harikrishnanm5/Flight-Data-Logger-PCB/BOM.csv

Designators | Qty | Value | Footprint | MPN | Placement_Side | Description
H1, H2, H3, H4 | 4 | M3_GND | MountingHole_3.2mm_M3_Pad_TopBottom | M3_HOLE | F | M3 Drone Stack Hole NW; M3 Drone Stack Hole NE; M3 Drone Stack Hole SW ...
U2 | 1 | ESP32-WROOM-32 | ESP32-WROOM-32 | ESP32-WROOM-32E-N4 | F | Wi-Fi/BLE Telemetry Module
U1 | 1 | STM32F446RET6 | LQFP-64_10x10mm_P0.5mm | STM32F446RET6 | F | ARM Cortex-M4F MCU 180MHz 512KB
U3 | 1 | MPU-6050 | InvenSense_QFN-24_4x4mm_P0.5mm | MPU-6050 | F | 6-Axis IMU (I2C 0x68, AD0=GND)
U4 | 1 | BMP280 | Bosch_LGA-8_2x2.5mm_P0.65mm_ClockwisePinNumbering | BMP280 | F | Barometric Pressure Sensor (I2C 0x76)
J3 | 1 | MicroSD_SPI | microSD_HC_Hirose_DM3D-SF | DM3D-SF | F | MicroSD Card Push-Pull Socket (SPI)
C_SC1 | 1 | 1.0F_5.5V | DX_5R5VxxxxU_D11.5mm_P5.00mm | DX-5R5V105U | F | 5.5V 1.0F Backup Supercapacitor
J1 | 1 | JST_PH_BATT | JST_PH_B2B-PH-K_1x02_P2.00mm_Vertical | B2B-PH-K-S | F | 3.7V Li-ion Input JST-PH 2-Pin
J2 | 1 | SWD_5P | PinHeader_1x05_P2.54mm_Vertical | HDR-1x5-2.54 | F | SWD Debug (3V3, SWCLK, GND, SWDIO, NRST)
J4 | 1 | ESP_UART_6P | PinHeader_1x06_P1.27mm_Vertical | HDR-1x6-1.27 | F | ESP32 UART/Flash 6-Pin Header
SW1 | 1 | RESET | SW_SPST_CK_KXT3 | KXT311LHS | F | MCU Reset Tactile Switch
D1 | 1 | BEACON_LED_HI | LED_PLCC_2835 | SM2835-RED-HI | F | High-Intensity Optical Emergency Beacon LED
D2 | 1 | STAT_GREEN | LED_0603_1608Metric | LTST-C190KGKT | F | Status / Logger Activity LED (PC5)
D3 | 1 | PWR_BLUE | LED_0603_1608Metric | LTST-C190TBKT | F | 3.3V Power Indicator LED
Y1 | 1 | 8MHz | Crystal_SMD_3225-4Pin_3.2x2.5mm | ABM8-8.000MHZ-B2-T | F | 8 MHz HSE Crystal
Y2 | 1 | 32.768kHz | Crystal_SMD_3215-2Pin_3.2x1.5mm | ABS07-32.768KHZ-T | F | 32.768 kHz LSE RTC Crystal
C3, C4 | 2 | 18pF | C_0603_1608Metric | CC0603JRNPO9BN180 | F | HSE Load Cap 1; HSE Load Cap 2
C5, C6 | 2 | 12pF | C_0603_1608Metric | CC0603JRNPO9BN120 | F | LSE Load Cap 1; LSE Load Cap 2
R5, R6, R7, R8, R9, R10, R20, R11, R23, R25, R26, R36, R12, R13, R14, R15 | 16 | 10k | R_0603_1608Metric | RC0603FR-0710KL | B/F | SD_CS Pull-up; SPI1_MISO Pull-up; SPI1_MOSI Pull-up ...
C21, C27 | 2 | 10uF | C_0805_2012Metric | CL21A106KAYNNNE | B/F | SD VDD Bulk Cap; Buck Input Decoupling Cap
C22, C17, C19, C20, C31, C32, C1, C14, C8, C9, C10, C11, C2, C15, C16, C24, C25 | 17 | 100nF | C_0603_1608Metric | CC0603KRX7R7BB104 | B/F | SD VDD Decoupling Cap; MPU-6050 REGOUT Cap; BMP280 VDD Decoupling ...
Q4 | 1 | 2N7002 | SOT-23 | 2N7002LT1G | F | Beacon N-MOSFET Driver
R18 | 1 | 22R | R_0805_2012Metric | ERJ-6GEYJ220V | F | Beacon LED Current Limit
R19, R16, R17 | 3 | 100R | R_0603_1608Metric | RC0603FR-07100RL | B/F | Beacon Gate Series R; USART1 TX -> ESP RXD0 Series; ESP TXD0 -> USART1 RX Series
R21, R22 | 2 | 1k | R_0603_1608Metric | RC0603FR-071KL | F | Status LED Resistor; Power LED Resistor
R3, R4 | 2 | 4.7k | R_0603_1608Metric | RC0603FR-074K7L | F | I2C1 SCL Pull-up; I2C1 SDA Pull-up
C18 | 1 | 2.2nF | C_0603_1608Metric | CC0603KRX7R9BB222 | F | MPU-6050 CPOUT Charge Pump Cap
U5 | 1 | CY15B102QN-50SXIT | SOIC-8_3.9x4.9mm_P1.27mm | CY15B102QN-50SXIT | B | 2 Mbit SPI FRAM Non-Volatile Memory
Q1, Q2, Q3 | 3 | AO3401A | SOT-23 | AO3401A | B | Reverse-Polarity P-MOSFET; Primary Battery Ideal Diode P-MOSFET; Supercap Backup Ideal Diode P-MOSFET
C26, C13 | 2 | 1uF | C_0603_1608Metric | CL10A105KB8NNNC | B | Fast-Trip Input Cap; VDDA Bulk Cap
U7, U8 | 2 | LTC4412ES6 | TSOT-23-6 | LTC4412ES6#TRPBF | B | Primary Battery PowerPath Ideal Diode Ctrl; Supercap Backup Ideal Diode OR-ing Ctrl
U11 | 1 | AP22814AW5 | SOT-23-5 | AP22814AW5-7 | B | Slew-Limited Supercap Charge Switch
R24 | 1 | 15R | R_0805_2012Metric | ERJ-6GEYJ150V | B | Supercap Charge Current Limit (~200mA)
D4 | 1 | B5819W | D_SOD-123 | B5819W-7-F | B | Supercap Blocking Schottky Diode
U6 | 1 | TPS62822DLC | Texas_VSON-HR-8_1.5x2mm_P0.5mm | TPS62822DLCR | B | 3.3V 2A Synchronous Buck Regulator
L1 | 1 | 1.0uH_3.5A | L_Wuerth_MAPI-3015 | 74438334010 | B | 1.0uH Shielded Buck Power Inductor
C28, C29, C23 | 3 | 22uF | C_0805_2012Metric | CL21A226MAYNNNE | B | Buck Output Bulk Cap 1; Buck Output Bulk Cap 2; ESP32 VDD Bulk Cap
R27 | 1 | 45.3k_1% | R_0603_1608Metric | RC0603FR-0745K3L | B | Buck FB Top (3.318V)
R28, R31, R32, R34 | 4 | 10.0k_1% | R_0603_1608Metric | RC0603FR-0710KL | B | Buck FB Bottom; PFD Ref Divider Top (1.250V); PFD Ref Divider Bottom ...
C30 | 1 | 22pF | C_0603_1608Metric | CC0603JRNPO9BN220 | B | Buck FB Feedforward Cap
R29 | 1 | 100k | R_0603_1608Metric | RC0603FR-07100KL | B | Buck PG Pull-up
U9 | 1 | TLV7031DBV | SOT-23-5 | TLV7031DBVR | B | PFD Comparator (3.00V Trip -> PB1 EXTI1)
U10 | 1 | LM4040DBZ-2.5 | SOT-23 | LM4040AIM3-2.5 | B | 2.500V Precision Shunt Reference
R30 | 1 | 1.5k | R_0603_1608Metric | RC0603FR-071K5L | B | LM4040 Bias Resistor
R33 | 1 | 14.0k_1% | R_0603_1608Metric | RC0603FR-0714KL | B | PFD Sense Divider Top (3.00V)
R35 | 1 | 470k | R_0603_1608Metric | RC0603FR-07470KL | B | PFD Positive Hysteresis (~53mV)
R1 | 1 | 10k_0.1% | R_0603_1608Metric | ERA-3AEB103V | B | ADC1 Divider Top (0.1%)
R2 | 1 | 2k_0.1% | R_0603_1608Metric | ERA-3AEB202V | B | ADC1 Divider Bottom (0.1%)
FB1 | 1 | 600R@100MHz | L_0603_1608Metric | BLM18AG601SN1D | B | VDDA Analog Filter Bead
C7 | 1 | 2.2uF | C_0603_1608Metric | CL10A225KQ8NNNC | B | STM32 VCAP_1 Core Cap
C12 | 1 | 4.7uF | C_0603_1608Metric | CL10A475KQ8NNNC | B | MCU VDD Bulk Cap
