harikrishnanm5/Flight-Data-Logger-PCB/layers/FlightDataLogger-B_Cu.pdf

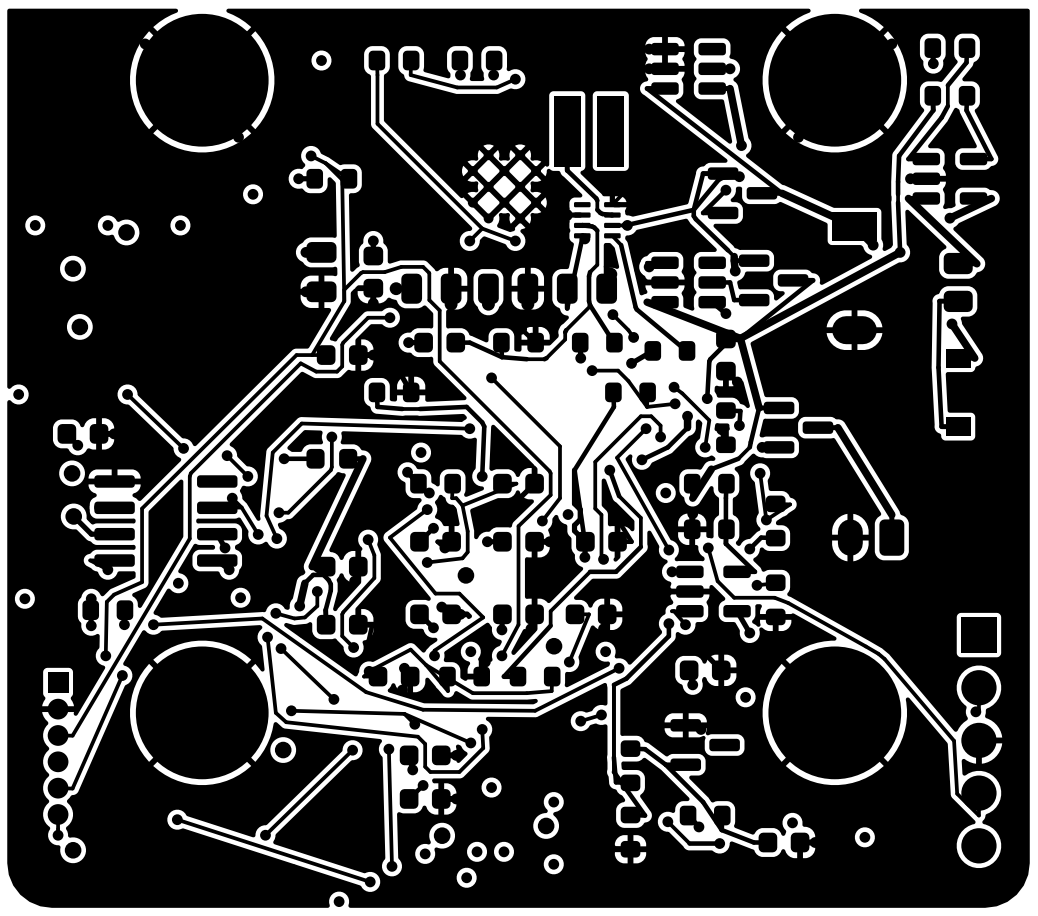
[picture p1: page 1]
