harikrishnanm5/Flight-Data-Logger-PCB/layers/FlightDataLogger-Edge_Cuts.pdf

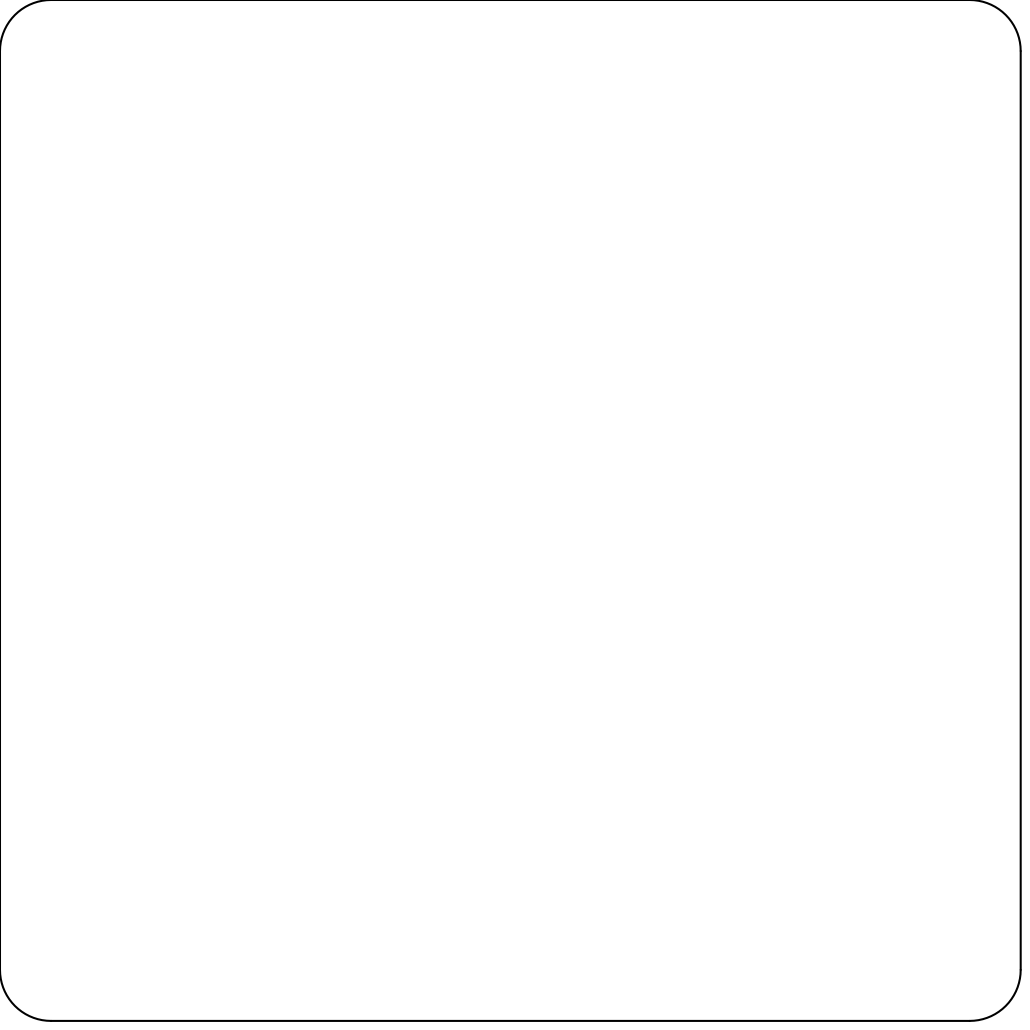
[picture p2: page 1]
