harikrishnanm5/Flight-Data-Logger-PCB/layers/FlightDataLogger-F_Cu.pdf

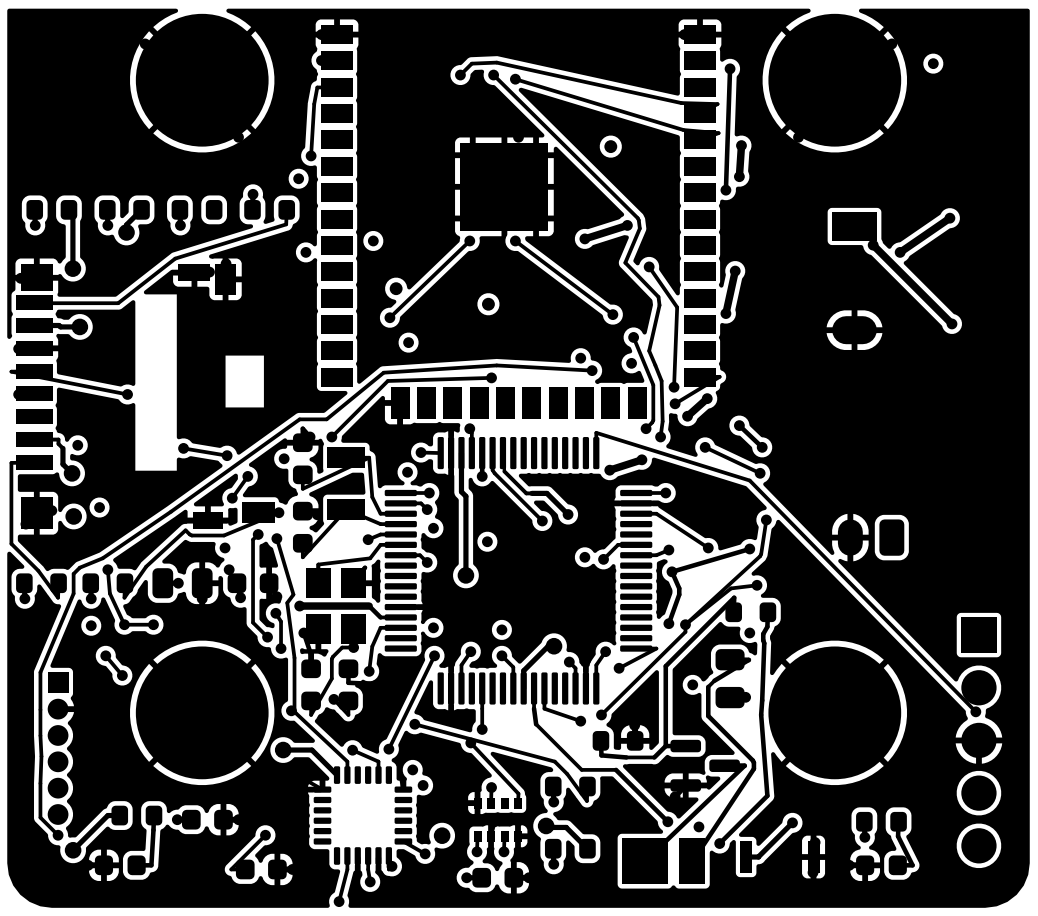
[picture p3: page 1]
