harikrishnanm5/Flight-Data-Logger-PCB/layers/FlightDataLogger-In1_Cu.pdf

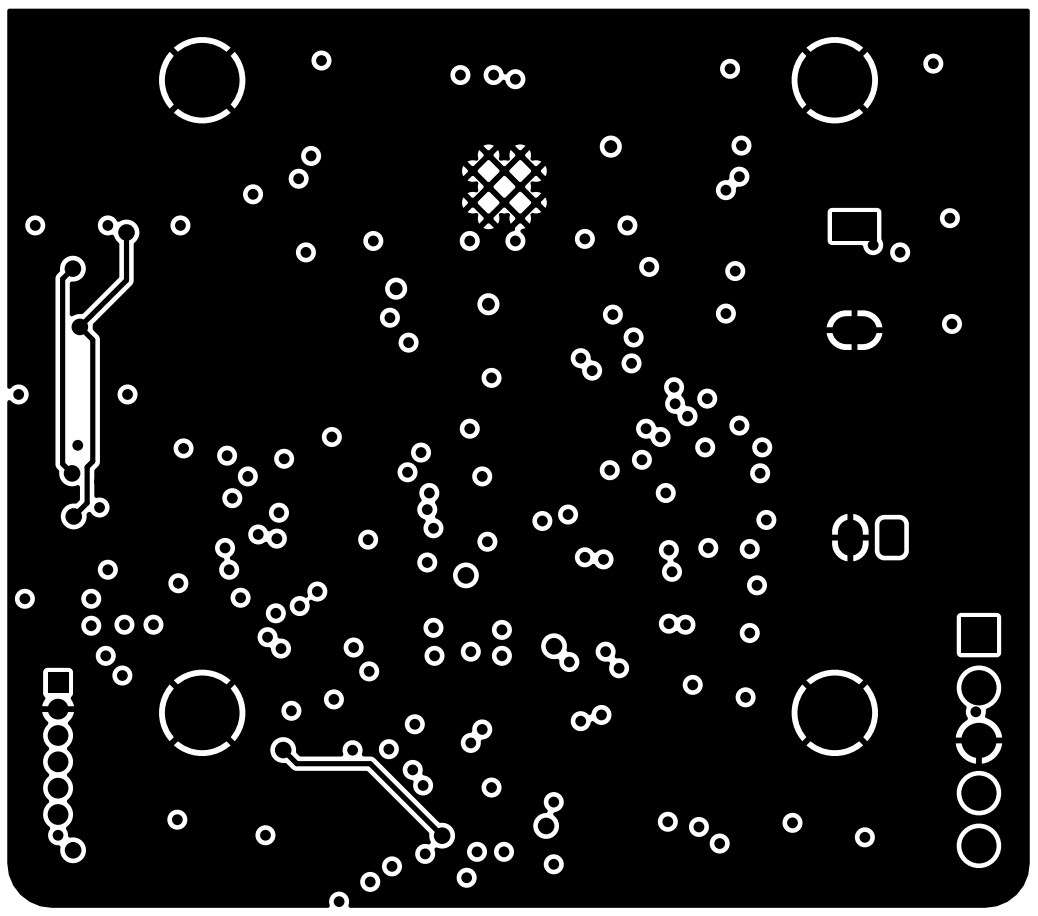
[picture p4: page 1]
