harikrishnanm5/Flight-Data-Logger-PCB/layers/FlightDataLogger-In2_Cu.pdf

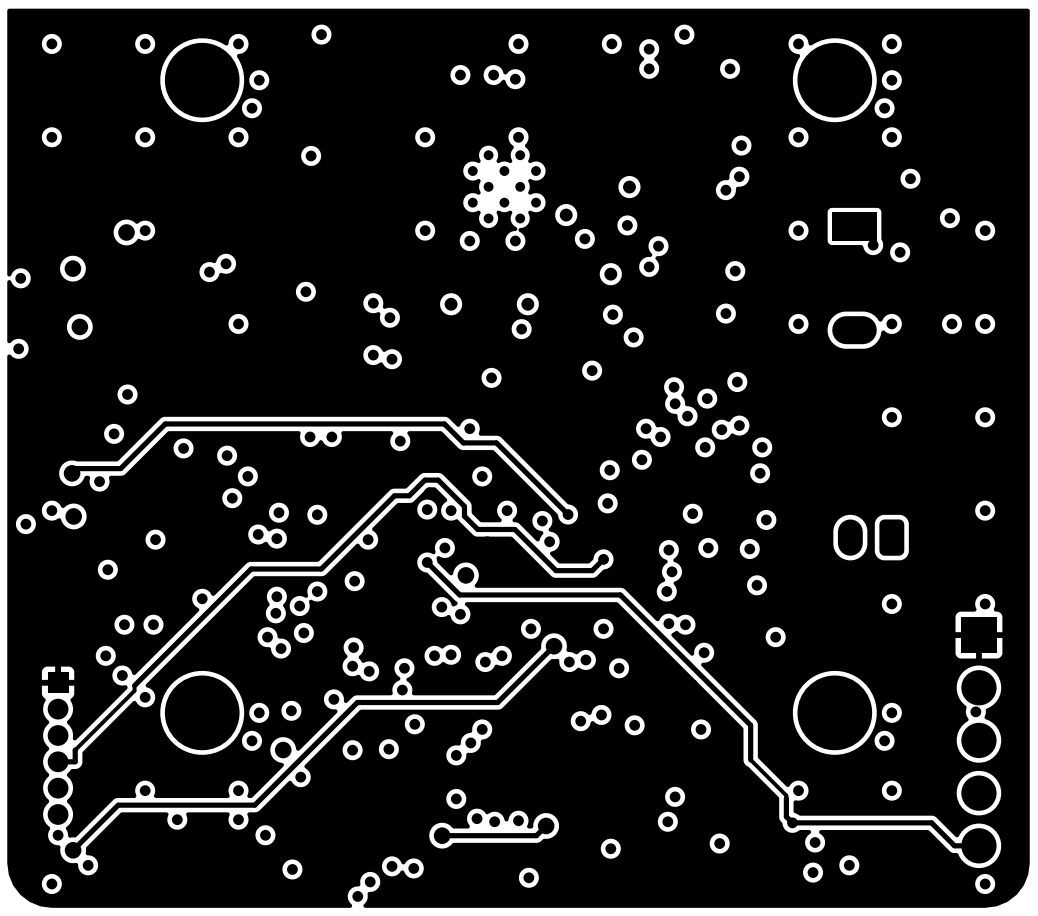
[picture p5: page 1]
