harikrishnanm5/Flight-Data-Logger-PCB/FlightDataLogger.kicad_pcb

## KiCad design FlightDataLogger.kicad_pcb (2026-11-12)

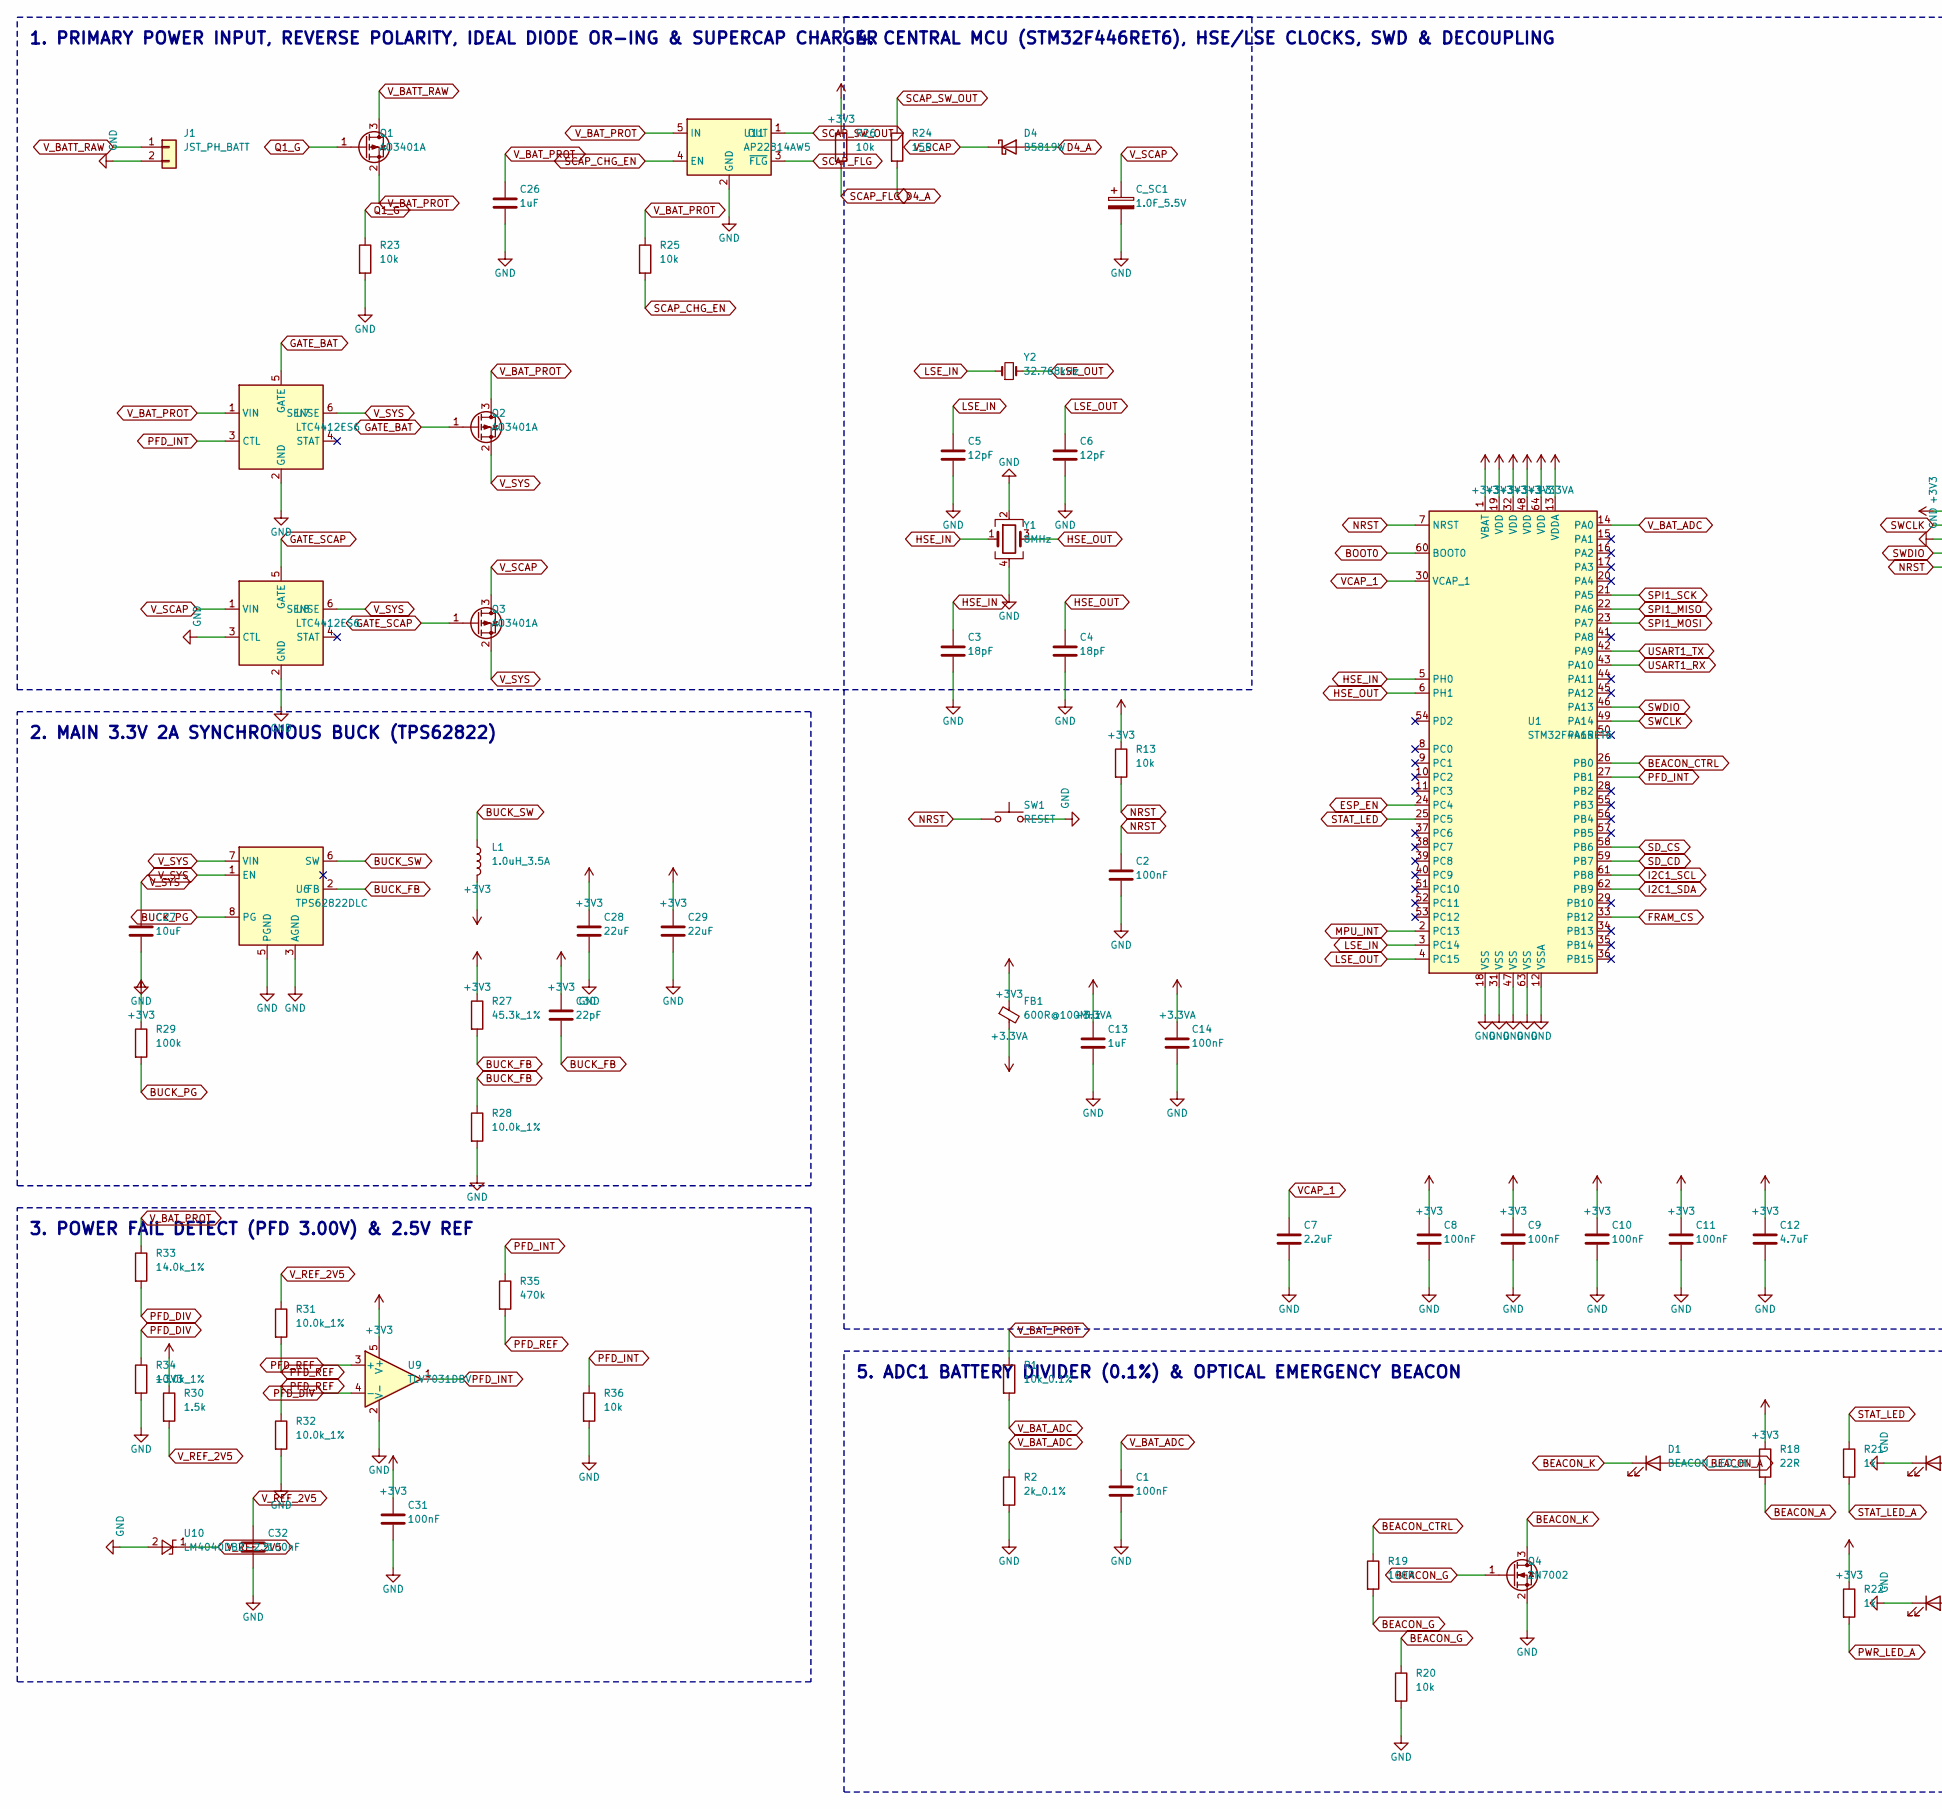
[picture p6: schematic FlightDataLogger.kicad_sch, Crash-Safe UAV Flight Data Logger (STM32F446RE + ESP32 + FR…, part in row 1, column 1]

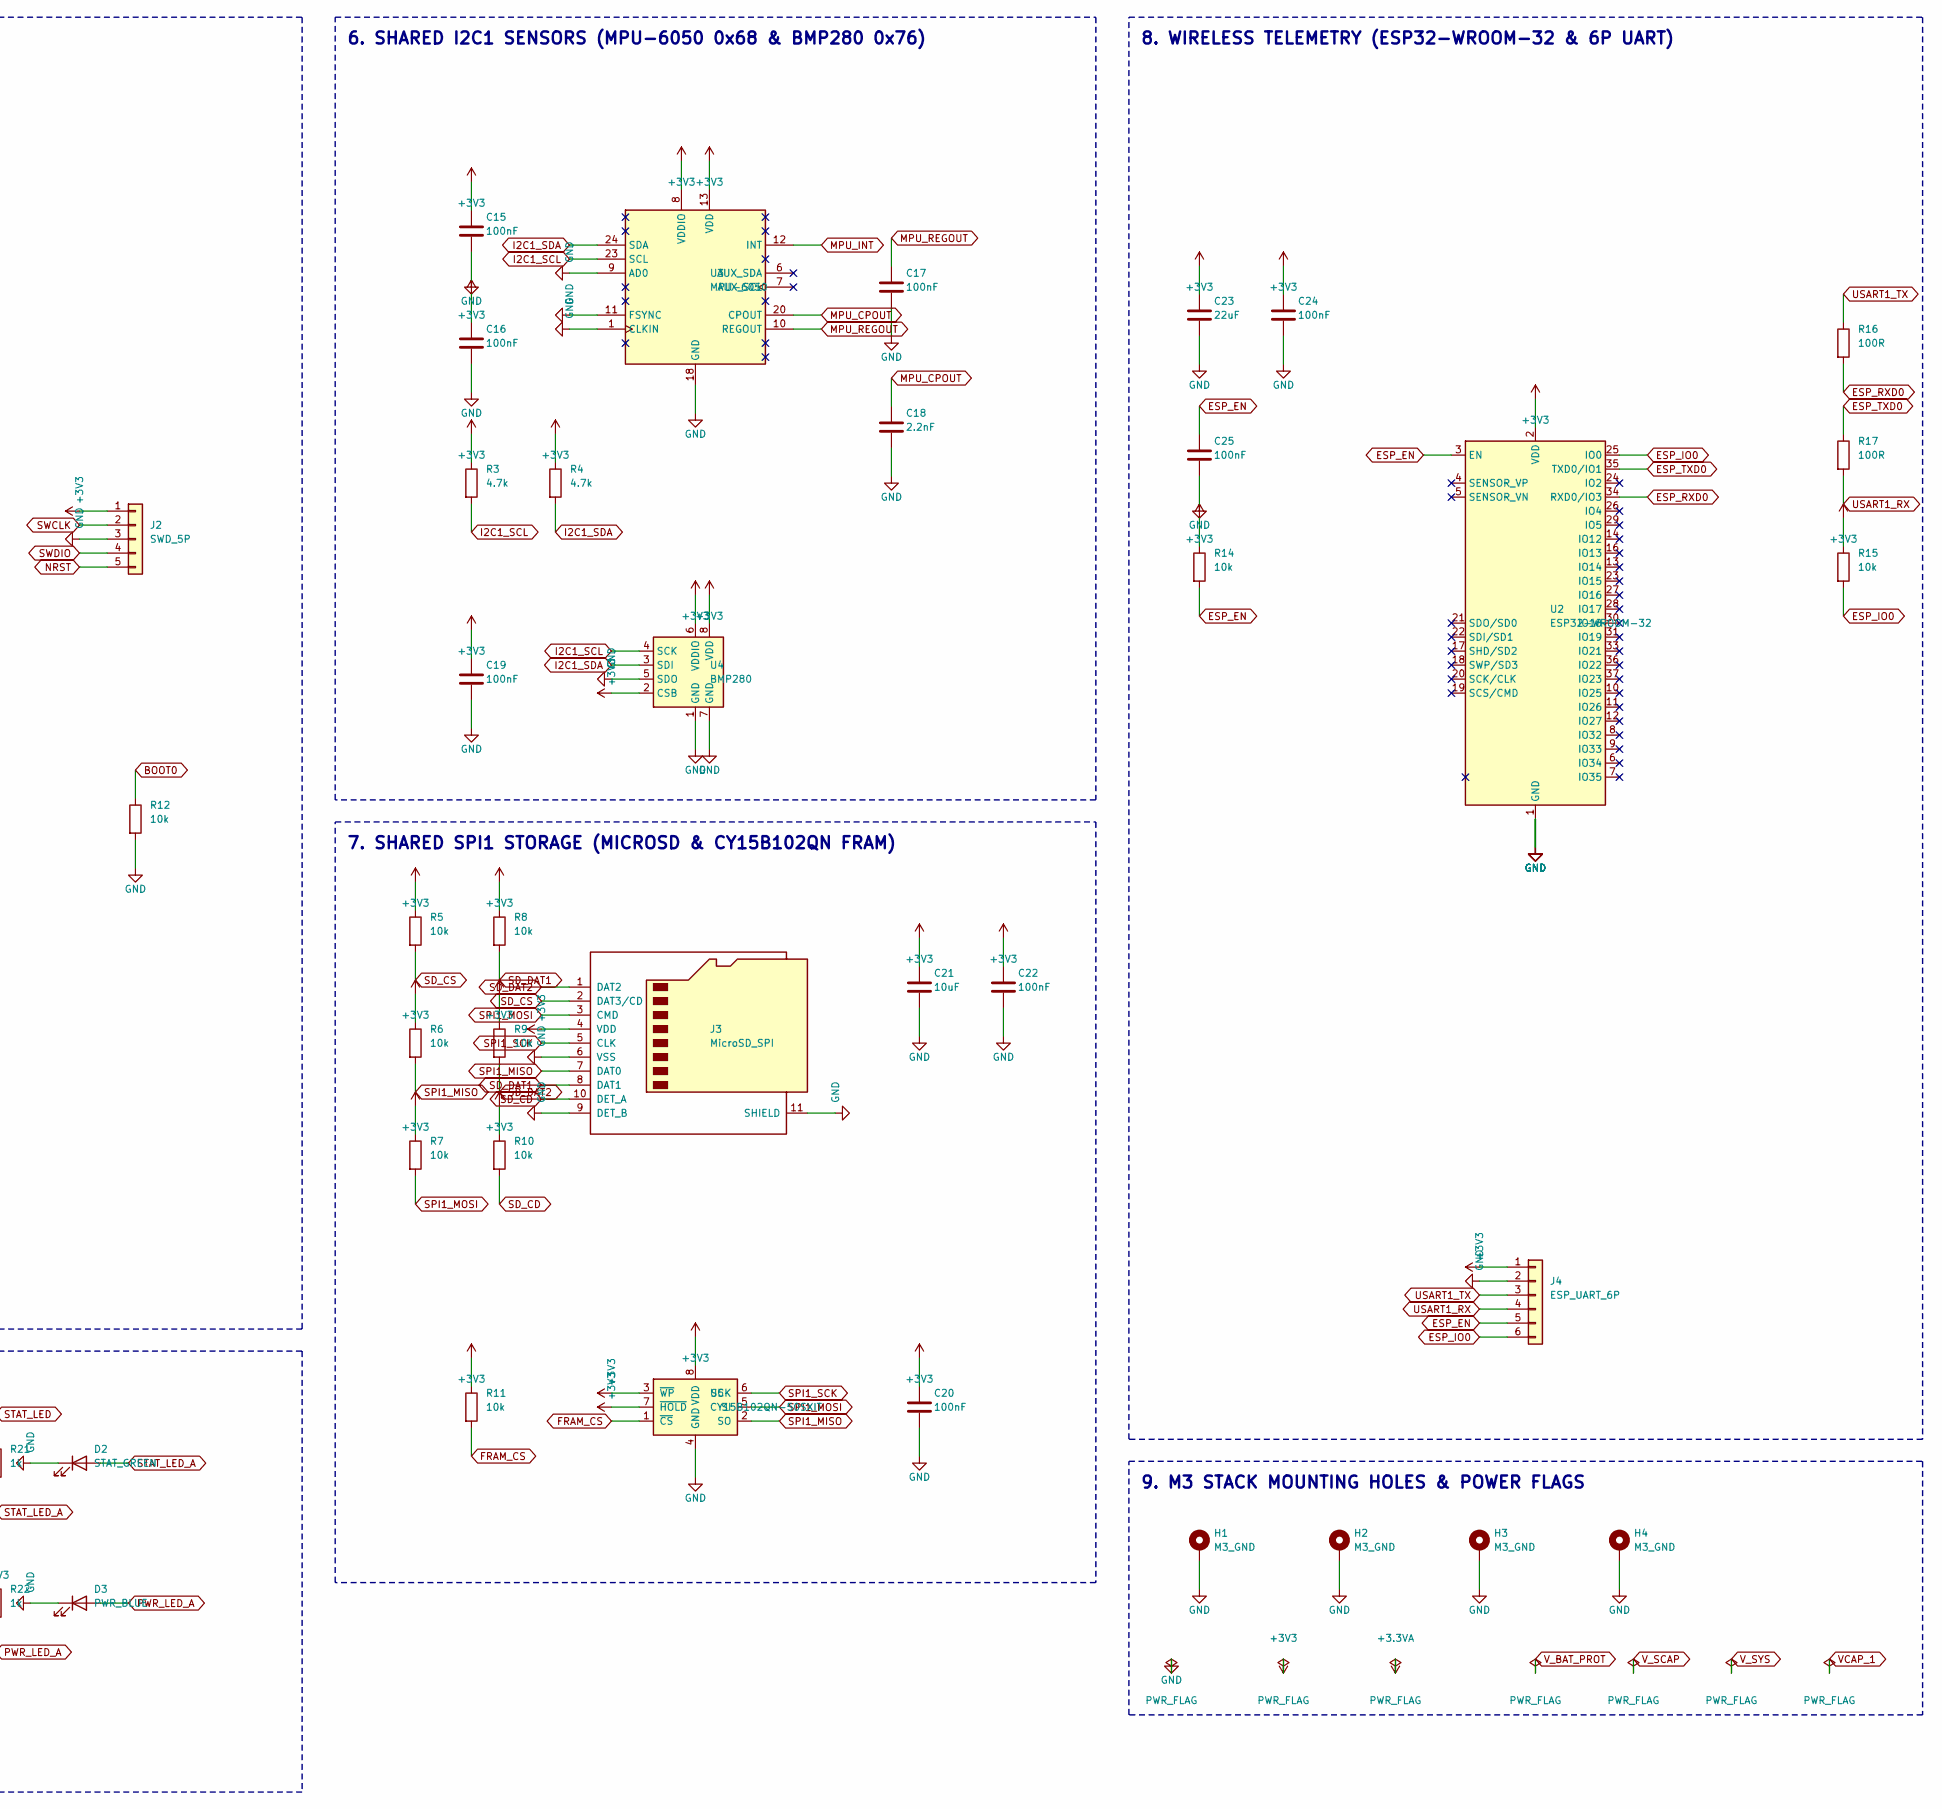
[picture p7: schematic FlightDataLogger.kicad_sch, Crash-Safe UAV Flight Data Logger (STM32F446RE + ESP32 + FR…, part in row 1, column 2]

Parts:
C1, C2, C8, C9, C10, C11, C14, C15, C16, C17, C19, C20, C22, C24, C25, C31, C32: 100nF; C_0603_1608Metric; MPN CC0603KRX7R7BB104
C3, C4: 18pF; C_0603_1608Metric; MPN CC0603JRNPO9BN180
C5, C6: 12pF; C_0603_1608Metric; MPN CC0603JRNPO9BN120
C7: 2.2uF; C_0603_1608Metric; MPN CL10A225KQ8NNNC
C12: 4.7uF; C_0603_1608Metric; MPN CL10A475KQ8NNNC
C13, C26: 1uF; C_0603_1608Metric; MPN CL10A105KB8NNNC
C18: 2.2nF; C_0603_1608Metric; MPN CC0603KRX7R9BB222
C21, C27: 10uF; C_0805_2012Metric; MPN CL21A106KAYNNNE
C23, C28, C29: 22uF; C_0805_2012Metric; MPN CL21A226MAYNNNE
C30: 22pF; C_0603_1608Metric; MPN CC0603JRNPO9BN220
C_SC1: 1.0F_5.5V; DX_5R5VxxxxU_D11.5mm_P5.00mm; MPN DX-5R5V105U
D1: BEACON_LED_HI; LED_PLCC_2835; MPN SM2835-RED-HI
D2: STAT_GREEN; LED_0603_1608Metric; MPN LTST-C190KGKT
D3: PWR_BLUE; LED_0603_1608Metric; MPN LTST-C190TBKT
D4: B5819W; D_SOD-123; MPN B5819W-7-F
FB1: 600R@100MHz; L_0603_1608Metric; MPN BLM18AG601SN1D
H1, H2, H3, H4: M3_GND; MountingHole_3.2mm_M3_Pad_TopBottom; MPN M3_HOLE
J1: JST_PH_BATT; JST_PH_B2B-PH-K_1x02_P2.00mm_Vertical; MPN B2B-PH-K-S
J2: SWD_5P; PinHeader_1x05_P2.54mm_Vertical; MPN HDR-1x5-2.54
J3: MicroSD_SPI; microSD_HC_Hirose_DM3D-SF; MPN DM3D-SF
J4: ESP_UART_6P; PinHeader_1x06_P1.27mm_Vertical; MPN HDR-1x6-1.27
L1: 1.0uH_3.5A; L_Wuerth_MAPI-3015; MPN 74438334010
Q1, Q2, Q3: AO3401A; SOT-23; MPN AO3401A
Q4: 2N7002; SOT-23; MPN 2N7002LT1G
R1: 10k_0.1%; R_0603_1608Metric; MPN ERA-3AEB103V
R2: 2k_0.1%; R_0603_1608Metric; MPN ERA-3AEB202V
R3, R4: 4.7k; R_0603_1608Metric; MPN RC0603FR-074K7L
R5, R6, R7, R8, R9, R10, R11, R12, R13, R14, R15, R20, R23, R25, R26, R36: 10k; R_0603_1608Metric; MPN RC0603FR-0710KL
R16, R17, R19: 100R; R_0603_1608Metric; MPN RC0603FR-07100RL
R18: 22R; R_0805_2012Metric; MPN ERJ-6GEYJ220V
R21, R22: 1k; R_0603_1608Metric; MPN RC0603FR-071KL
R24: 15R; R_0805_2012Metric; MPN ERJ-6GEYJ150V
R27: 45.3k_1%; R_0603_1608Metric; MPN RC0603FR-0745K3L
R28, R31, R32, R34: 10.0k_1%; R_0603_1608Metric; MPN RC0603FR-0710KL
R29: 100k; R_0603_1608Metric; MPN RC0603FR-07100KL
R30: 1.5k; R_0603_1608Metric; MPN RC0603FR-071K5L
R33: 14.0k_1%; R_0603_1608Metric; MPN RC0603FR-0714KL
R35: 470k; R_0603_1608Metric; MPN RC0603FR-07470KL
SW1: RESET; SW_SPST_CK_KXT3; MPN KXT311LHS
U1: STM32F446RET6; LQFP-64_10x10mm_P0.5mm; MPN STM32F446RET6
U2: ESP32-WROOM-32; MPN ESP32-WROOM-32E-N4
U3: MPU-6050; InvenSense_QFN-24_4x4mm_P0.5mm; MPN MPU-6050
U4: BMP280; Bosch_LGA-8_2x2.5mm_P0.65mm_ClockwisePinNumbering; MPN BMP280
U5: CY15B102QN-50SXIT; SOIC-8_3.9x4.9mm_P1.27mm; MPN CY15B102QN-50SXIT
U6: TPS62822DLC; Texas_VSON-HR-8_1.5x2mm_P0.5mm; MPN TPS62822DLCR
U7, U8: LTC4412ES6; TSOT-23-6; MPN LTC4412ES6#TRPBF
U9: TLV7031DBV; SOT-23-5; MPN TLV7031DBVR
U10: LM4040DBZ-2.5; SOT-23; MPN LM4040AIM3-2.5
U11: AP22814AW5; SOT-23-5; MPN AP22814AW5-7
Y1: 8MHz; Crystal_SMD_3225-4Pin_3.2x2.5mm; MPN ABM8-8.000MHZ-B2-T
Y2: 32.768kHz; Crystal_SMD_3215-2Pin_3.2x1.5mm; MPN ABS07-32.768KHZ-T

Connections:
+3.3VA: C13.1, C14.1, FB1.2, U1.13 (VDDA)
+3V3: C8.1, C9.1, C10.1, C11.1, C12.1, C15.1, C16.1, C19.1, C20.1, C21.1, C22.1, C23.1, C24.1, C28.1, C29.1, C30.1, C31.1, FB1.1, J2.1, J3.4 (VDD), J4.1, L1.2, R3.1, R4.1, R5.1, R6.1, R7.1, R8.1, R9.1, R10.1, R11.1, R13.1, R14.1, R15.1, R18.1, R22.1, R26.1, R27.1, R29.1, R30.1, U1.1 (VBAT), U1.19 (VDD), U1.32 (VDD), U1.48 (VDD), U1.64 (VDD), U2.2 (VDD), U3.8 (VDDIO), U3.13 (VDD), U4.2 (CSB), U4.6 (VDDIO), U4.8 (VDD), U5.3 (~WP), U5.7 (~HOLD), U5.8 (VDD), U9.5 (V+)
BEACON_A: D1.2 (A), R18.2
BEACON_CTRL: R19.1, U1.26 (PB0)
BEACON_G: Q4.1 (G), R19.2, R20.1
BEACON_K: D1.1 (K), Q4.3 (D)
BOOT0: R12.1, U1.60 (BOOT0)
BUCK_FB: C30.2, R27.2, R28.1, U6.2 (FB)
BUCK_PG: R29.2, U6.8 (PG)
BUCK_SW: L1.1, U6.6 (SW)
D4_A: D4.2 (A), R24.2
ESP_EN: C25.1, J4.5, R14.2, U1.24 (PC4), U2.3 (EN)
ESP_IO0: J4.6, R15.2, U2.25 (IO0)
ESP_RXD0: R16.2, U2.34 (RXD0/IO3)
ESP_TXD0: R17.1, U2.35 (TXD0/IO1)
FRAM_CS: R11.2, U1.33 (PB12), U5.1 (~CS)
GATE_BAT: Q2.1 (G), U7.5 (GATE)
GATE_SCAP: Q3.1 (G), U8.5 (GATE)
GND: C1.2, C2.2, C3.2, C4.2, C5.2, C6.2, C7.2, C8.2, C9.2, C10.2, C11.2, C12.2, C13.2, C14.2, C15.2, C16.2, C17.2, C18.2, C19.2, C20.2, C21.2, C22.2, C23.2, C24.2, C25.2, C26.2, C27.2, C28.2, C29.2, C31.2, C32.2, C_SC1.2, D2.1 (K), D3.1 (K), H1.1, H2.1, H3.1, H4.1, J1.2, J2.3, J3.6 (VSS), J3.9 (DET_B), J3.11 (SHIELD), J4.2, Q4.2 (S), R2.2, R12.2, R20.2, R23.2, R28.2, R32.2, R34.2, R36.2, SW1.2, U1.12 (VSSA), U1.18 (VSS), U1.31 (VSS), U1.47 (VSS), U1.63 (VSS), U2.1 (GND), U2.15 (GND), U2.38 (GND), U2.39 (GND), U3.1 (CLKIN), U3.9 (AD0), U3.11 (FSYNC), U3.18 (GND), U4.1 (GND), U4.5 (SDO), U4.7 (GND), U5.4 (GND), U6.3 (AGND), U6.5 (PGND), U7.2 (GND), U8.2 (GND), U8.3 (CTL), U9.2 (V-), U10.2 (A), U11.2 (GND), Y1.2, Y1.4
HSE_IN: C3.1, U1.5 (PH0), Y1.1
HSE_OUT: C4.1, U1.6 (PH1), Y1.3
I2C1_SCL: R3.2, U1.61 (PB8), U3.23 (SCL), U4.4 (SCK)
I2C1_SDA: R4.2, U1.62 (PB9), U3.24 (SDA), U4.3 (SDI)
LSE_IN: C5.1, U1.3 (PC14), Y2.1
LSE_OUT: C6.1, U1.4 (PC15), Y2.2
MPU_CPOUT: C18.1, U3.20 (CPOUT)
MPU_INT: U1.2 (PC13), U3.12 (INT)
MPU_REGOUT: C17.1, U3.10 (REGOUT)
NRST: C2.1, J2.5, R13.2, SW1.1, U1.7 (NRST)
PFD_DIV: R33.2, R34.1, U9.4 (-)
PFD_INT: R35.1, R36.1, U1.27 (PB1), U7.3 (CTL), U9.1
PFD_REF: R31.2, R32.1, R35.2, U9.3 (+)
PWR_LED_A: D3.2 (A), R22.2
Q1_G: Q1.1 (G), R23.1
SCAP_CHG_EN: R25.2, U11.4 (EN)
SCAP_FLG: R26.2, U11.3 (~FLG)
SCAP_SW_OUT: R24.1, U11.1 (OUT)
SD_CD: J3.10 (DET_A), R10.2, U1.59 (PB7)
SD_CS: J3.2 (DAT3/CD), R5.2, U1.58 (PB6)
SD_DAT1: J3.8 (DAT1), R8.2
SD_DAT2: J3.1 (DAT2), R9.2
SPI1_MISO: J3.7 (DAT0), R6.2, U1.22 (PA6), U5.2 (SO)
SPI1_MOSI: J3.3 (CMD), R7.2, U1.23 (PA7), U5.5 (SI)
SPI1_SCK: J3.5 (CLK), U1.21 (PA5), U5.6 (SCK)
STAT_LED: R21.1, U1.25 (PC5)
STAT_LED_A: D2.2 (A), R21.2
SWCLK: J2.2, U1.49 (PA14)
SWDIO: J2.4, U1.46 (PA13)
USART1_RX: J4.4, R17.2, U1.43 (PA10)
USART1_TX: J4.3, R16.1, U1.42 (PA9)
VCAP_1: C7.1, U1.30 (VCAP_1)
V_BATT_RAW: J1.1, Q1.3 (D)
V_BAT_ADC: C1.1, R1.2, R2.1, U1.14 (PA0)
V_BAT_PROT: C26.1, Q1.2 (S), Q2.3 (D), R1.1, R25.1, R33.1, U7.1 (VIN), U11.5 (IN)
V_REF_2V5: C32.1, R30.2, R31.1, U10.1 (K)
V_SCAP: C_SC1.1, D4.1 (K), Q3.3 (D), U8.1 (VIN)
V_SYS: C27.1, Q2.2 (S), Q3.2 (S), U6.1 (EN), U6.7 (VIN), U7.6 (SENSE), U8.6 (SENSE)

Notes on the sheet:
1. PRIMARY POWER INPUT, REVERSE POLARITY, IDEAL DIODE OR-ING & SUPERCAP CHARGER
2. MAIN 3.3V 2A SYNCHRONOUS BUCK (TPS62822)
3. POWER FAIL DETECT (PFD 3.00V) & 2.5V REF
4. CENTRAL MCU (STM32F446RET6), HSE/LSE CLOCKS, SWD & DECOUPLING
5. ADC1 BATTERY DIVIDER (0.1%) & OPTICAL EMERGENCY BEACON
6. SHARED I2C1 SENSORS (MPU-6050 0x68 & BMP280 0x76)
7. SHARED SPI1 STORAGE (MICROSD & CY15B102QN FRAM)
8. WIRELESS TELEMETRY (ESP32-WROOM-32 & 6P UART)
9. M3 STACK MOUNTING HOLES & POWER FLAGS

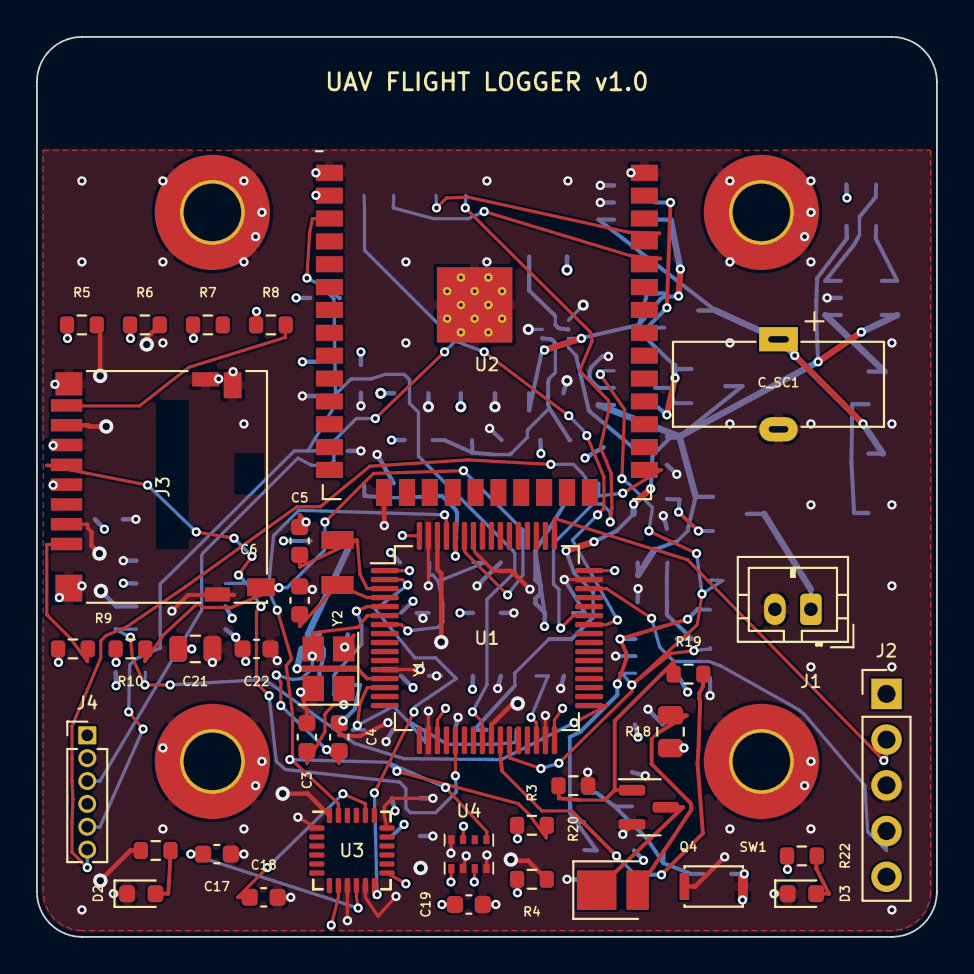
[picture p8: board FlightDataLogger.kicad_pcb from above]

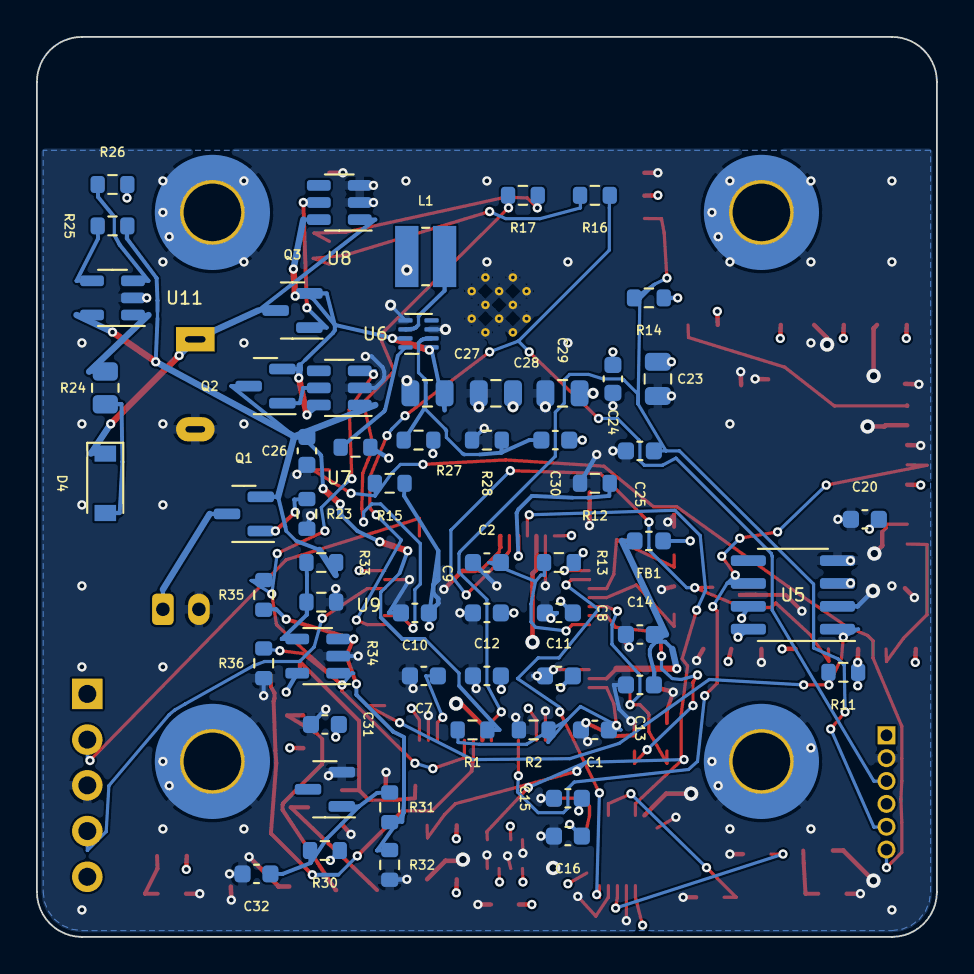
[picture p9: board FlightDataLogger.kicad_pcb from below]

Board: 4 copper layers, 50.0 x 50.0 mm, 101 parts (59 on the bottom side), 57 nets.
