harikrishnanm5/Flight-Data-Logger-PCB/(commit log)

2026-11-12 feat: add 4-layer UAV flight data logger KiCad project and scripts
    [FlightDataLogger.kicad_pcb, FlightDataLogger.kicad_sch]
2026-11-12 docs: add architecture documentation, specifications, and BOM
    [BOM.csv]
